ermilindwalekar/f1-dual-controller-stand/analysis/central_seat_15deg_y-20.png

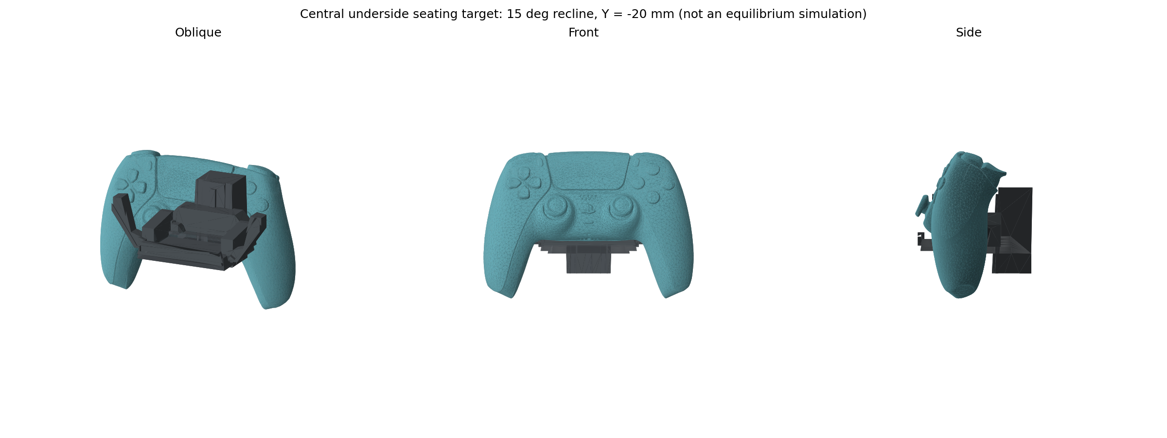
analysis/central_seat_15deg_y-20.png
