ermilindwalekar/f1-dual-controller-stand/analysis/dualsense_scan_views.png

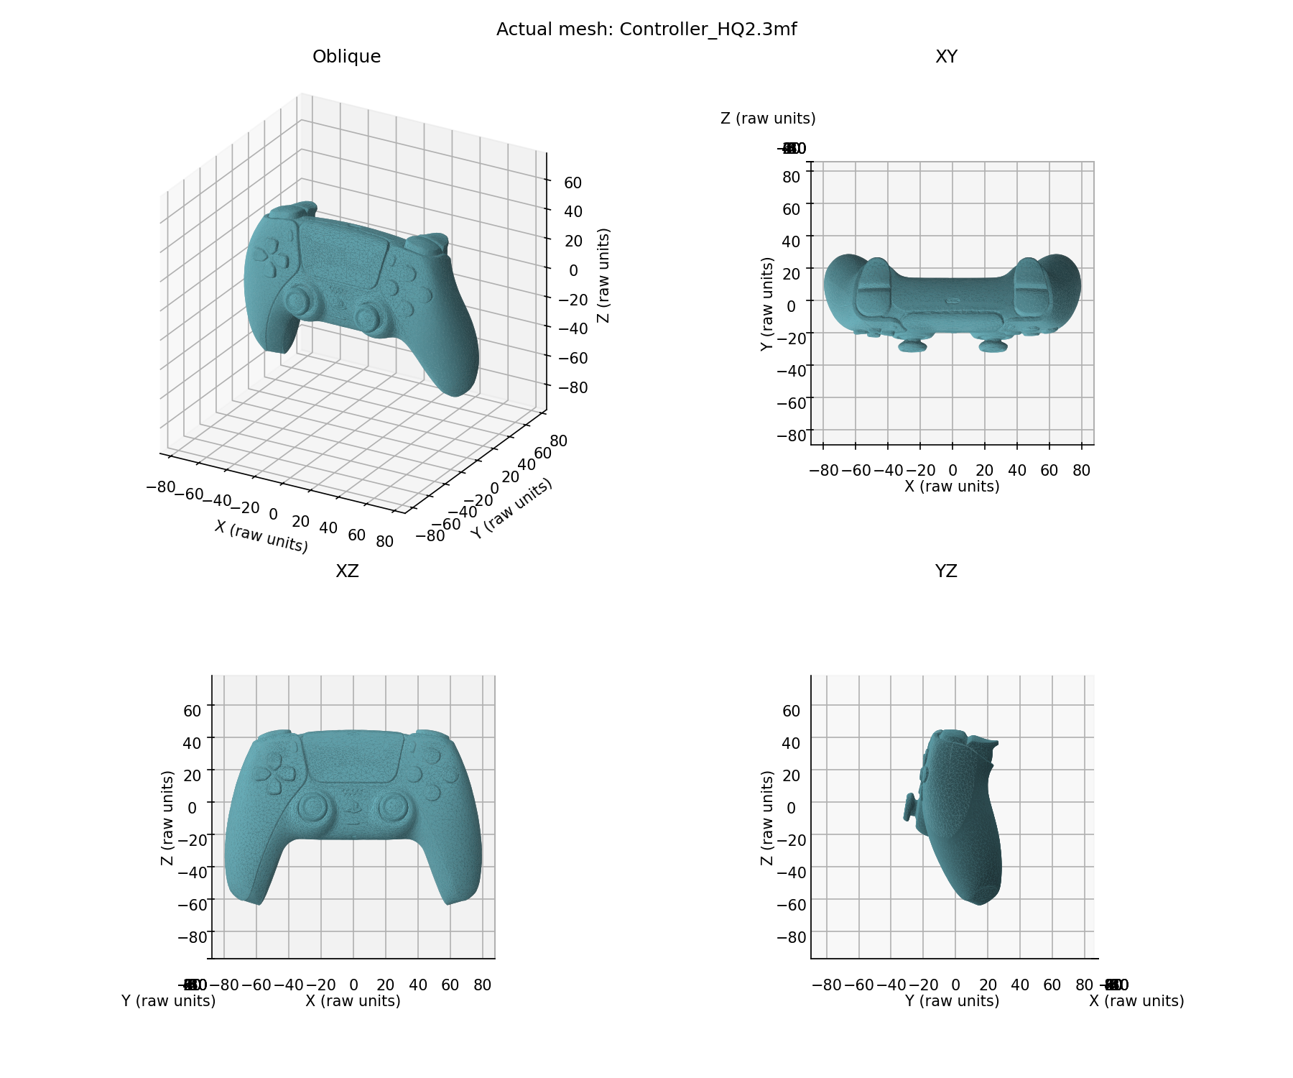
analysis/dualsense_scan_views.png
