ermilindwalekar/f1-dual-controller-stand/analysis/first_reference_mesh.png

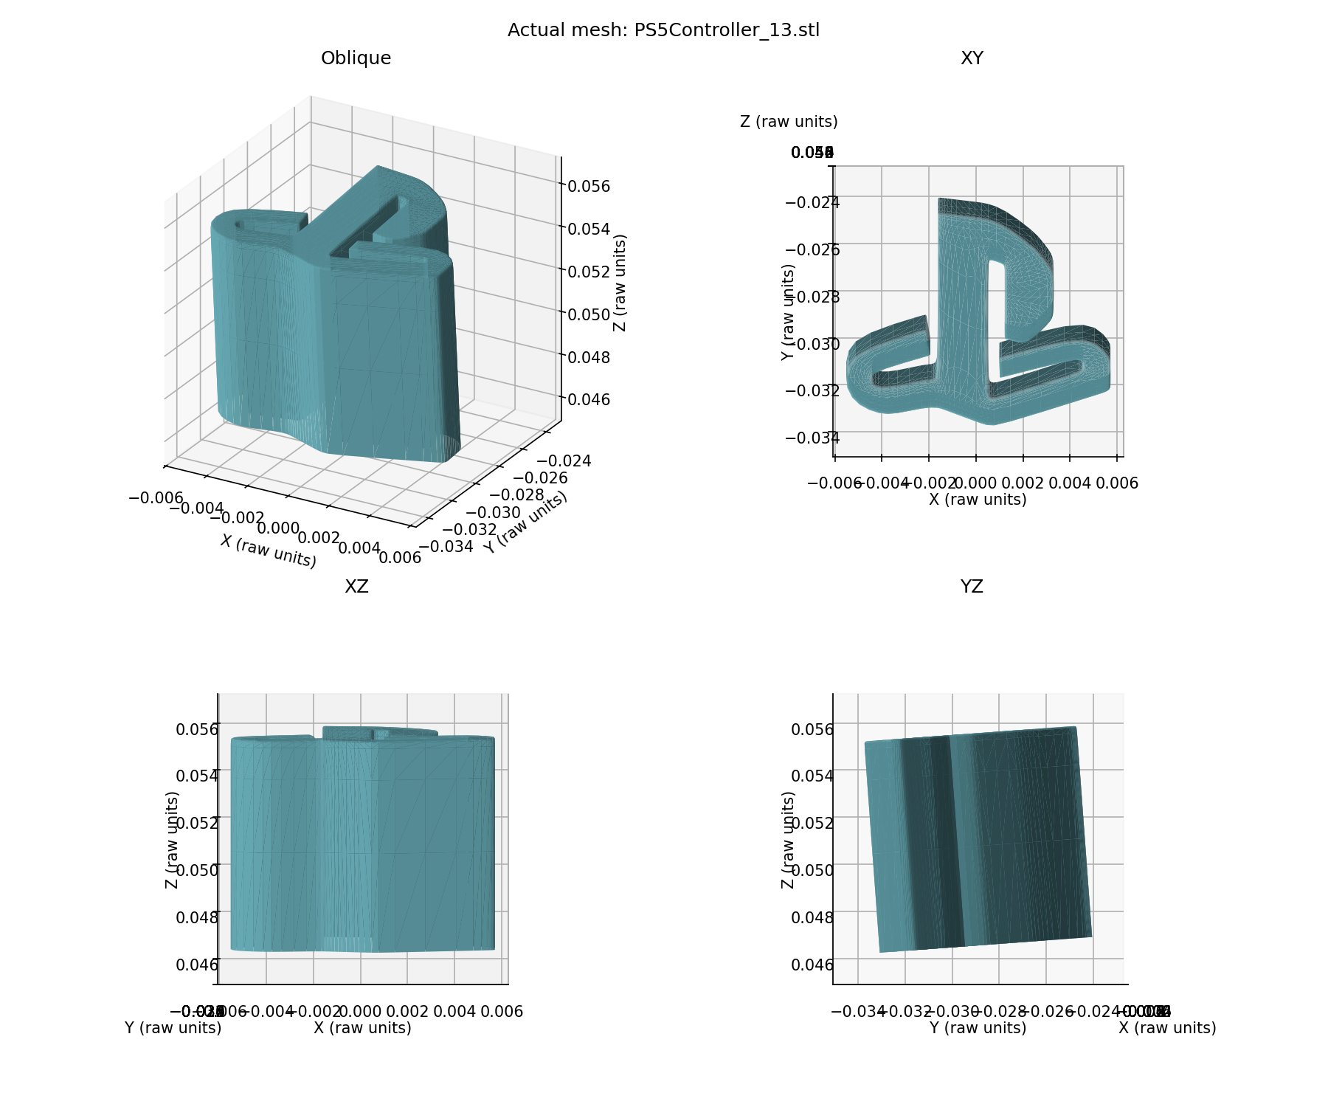
analysis/first_reference_mesh.png
