ermilindwalekar/f1-dual-controller-stand/analysis/fit_pose_0deg.png

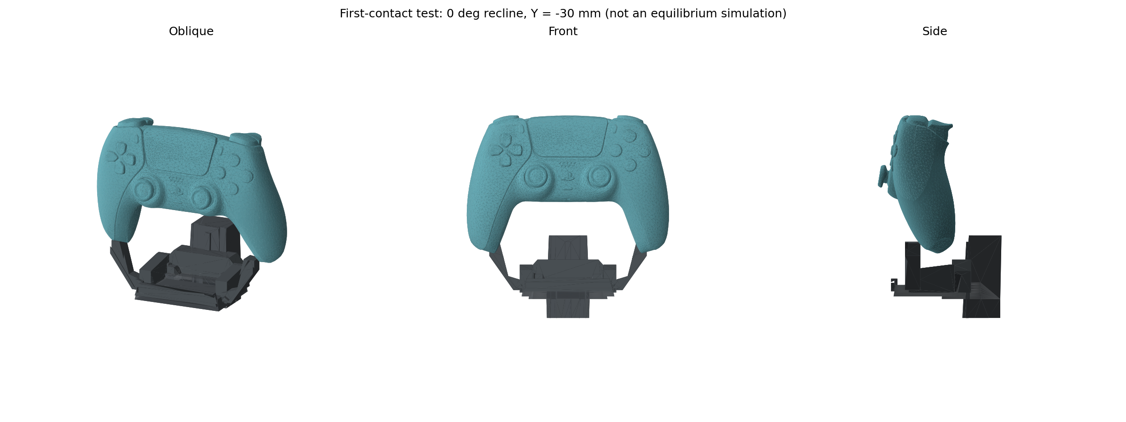
analysis/fit_pose_0deg.png
