ermilindwalekar/f1-dual-controller-stand/analysis/fit_pose_60deg.png

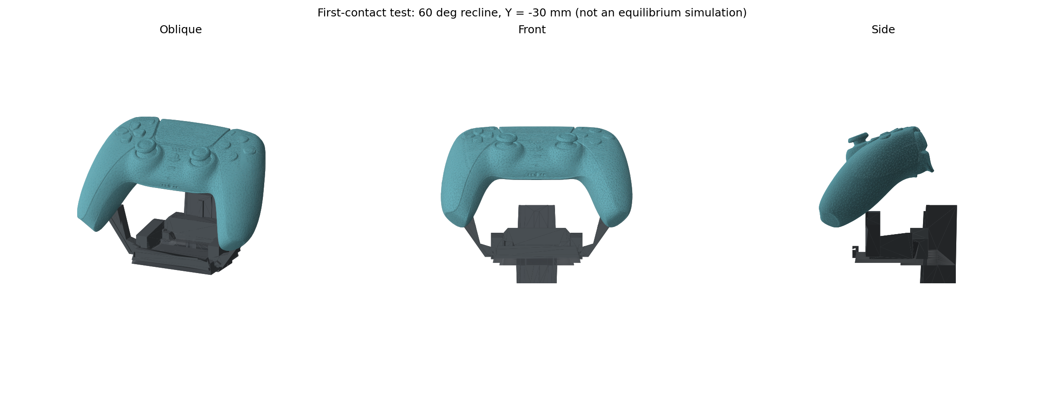
analysis/fit_pose_60deg.png
