ermilindwalekar/f1-dual-controller-stand/f1_dual_controller_stand_cradle_detail.png

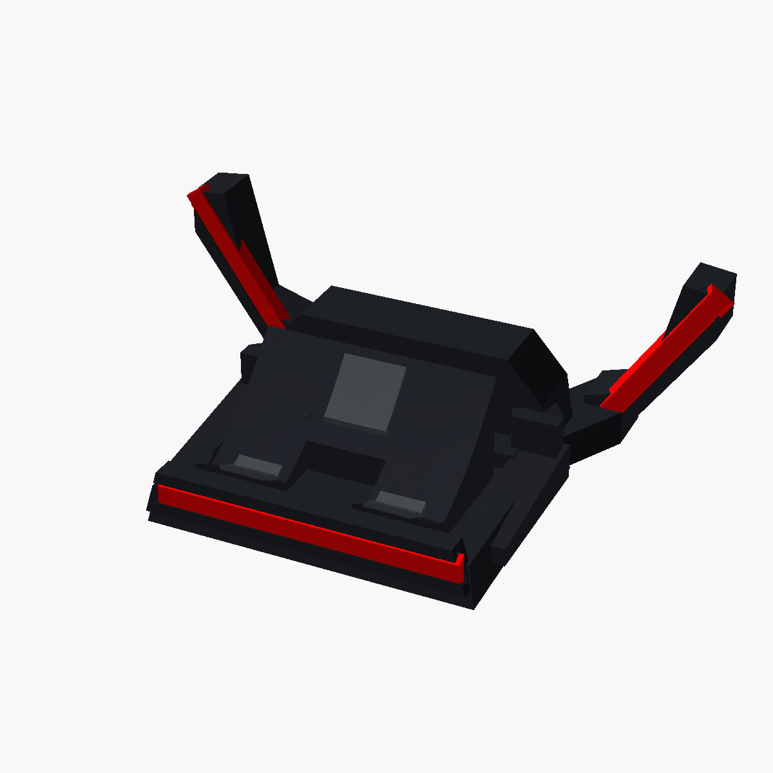
f1_dual_controller_stand_cradle_detail.png
