ermilindwalekar/f1-dual-controller-stand/f1_dual_controller_stand_exploded.png

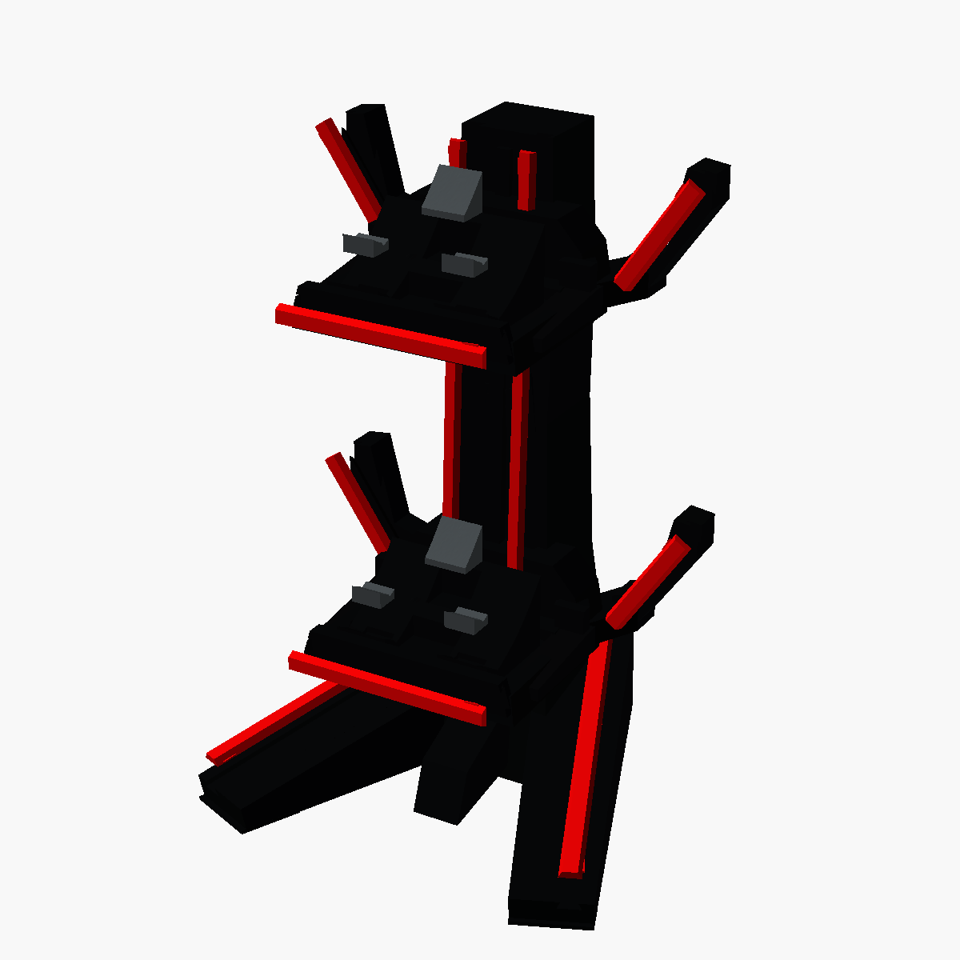
f1_dual_controller_stand_exploded.png
