ermilindwalekar/f1-dual-controller-stand/f1_dual_controller_stand_top.png

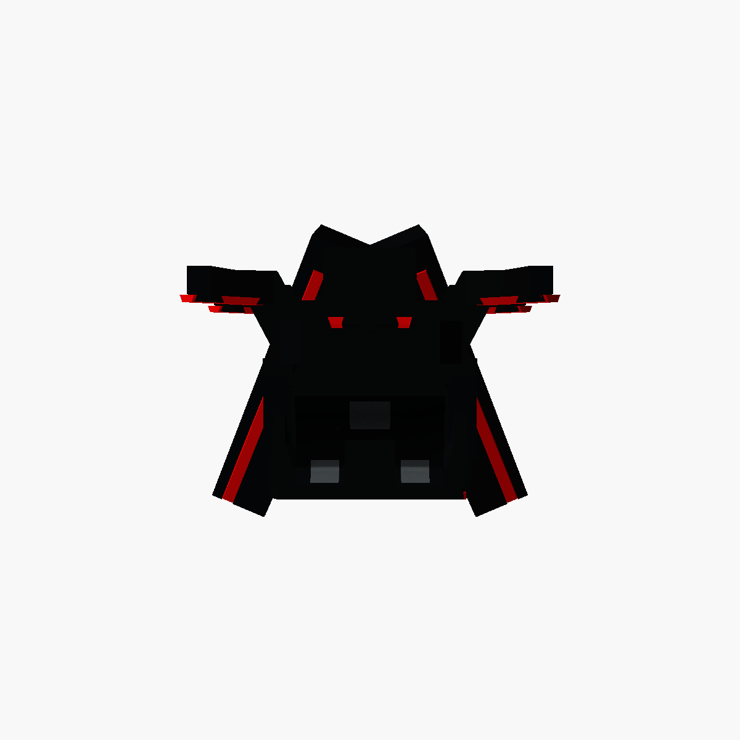
f1_dual_controller_stand_top.png
