ermilindwalekar/f1-dual-controller-stand/references/dualsense-scan/Screenshot_20251229_160554.png

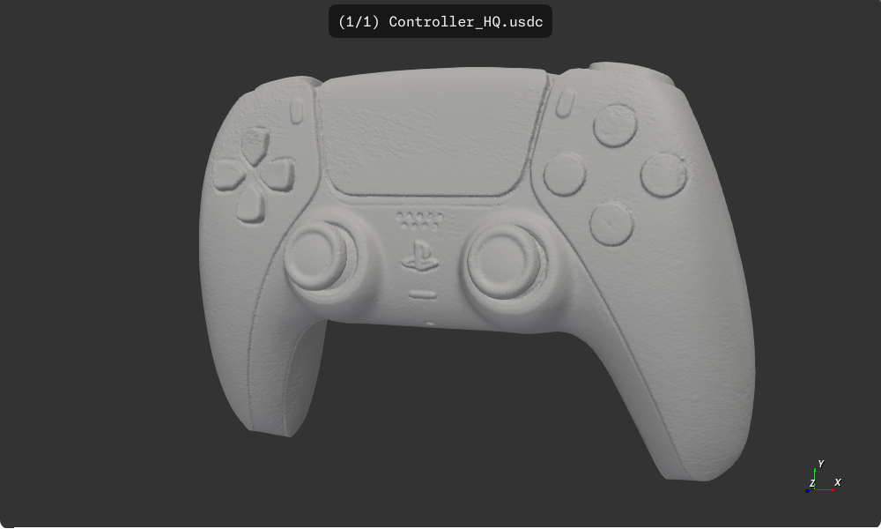
references/dualsense-scan/Screenshot_20251229_160554.png
