ermilindwalekar/f1-dual-controller-stand/references/grabcad-ps5-controller-13/4.png

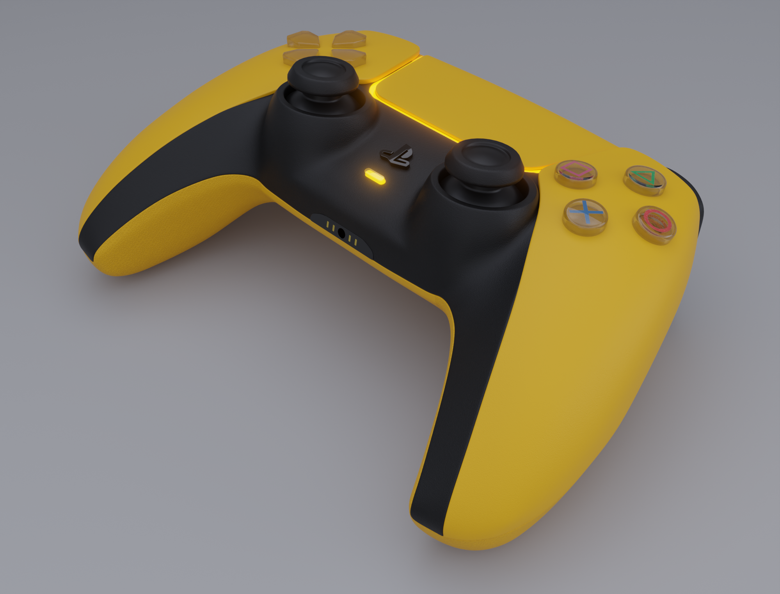
references/grabcad-ps5-controller-13/4.png
