ermilindwalekar/f1-dual-controller-stand/analysis/revised_hard_assembly.stl

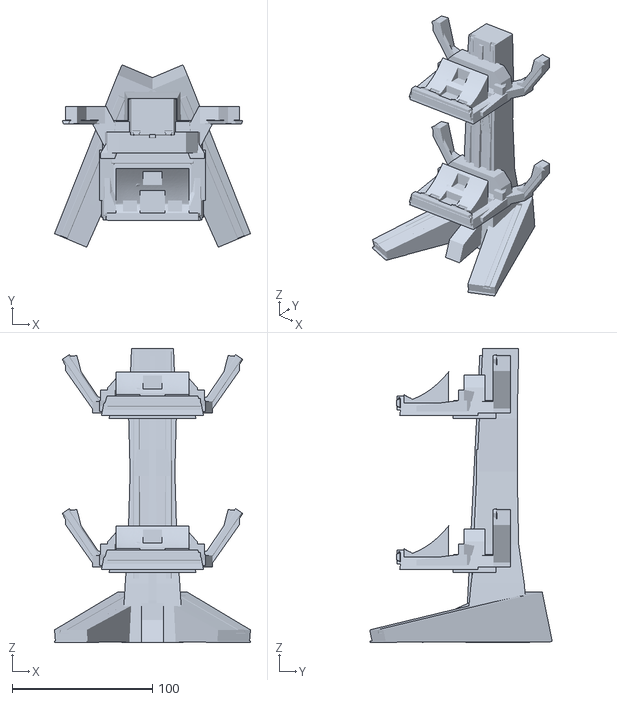
[picture p15: CAD file, 2026-10-31]
analysis/revised_hard_assembly.stl
140.0 x 130.4 x 210.0
