ermilindwalekar/f1-dual-controller-stand/f1_dual_controller_stand_red_spine_inserts.stl

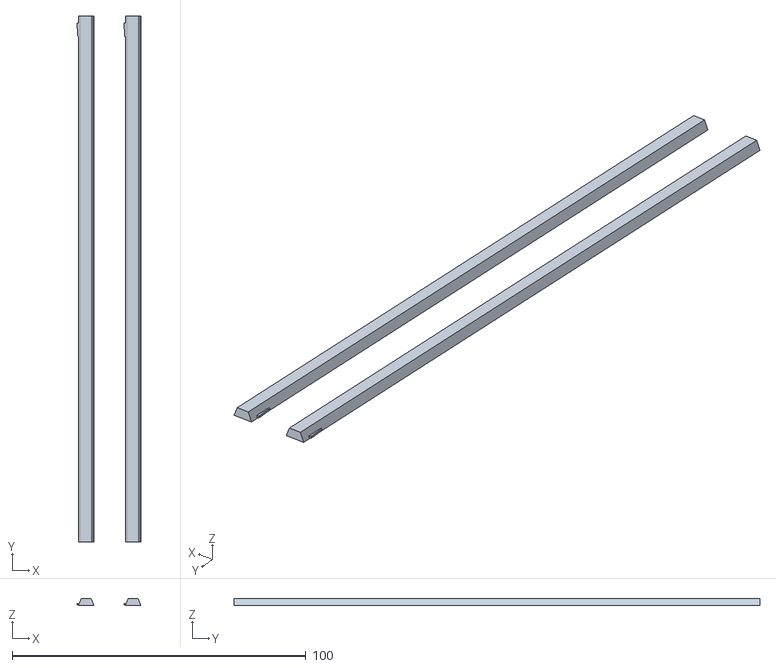
[picture p16: CAD file, 2026-10-31]
f1_dual_controller_stand_red_spine_inserts.stl
21.8 x 179.2 x 2.46
