ermilindwalekar/f1-dual-controller-stand/generated/seat_pad_2.stl

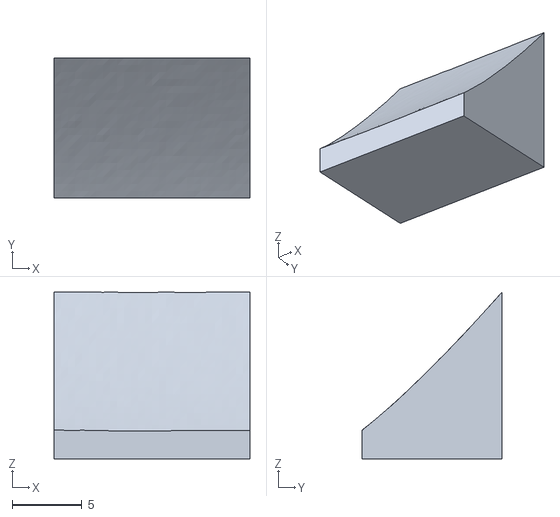
[picture p17: CAD file, 2026-10-31]
generated/seat_pad_2.stl
14.0 x 10.0 x 11.9
