ermilindwalekar/f1-dual-controller-stand/references/dualsense-scan/Controller_HQ2.3mf

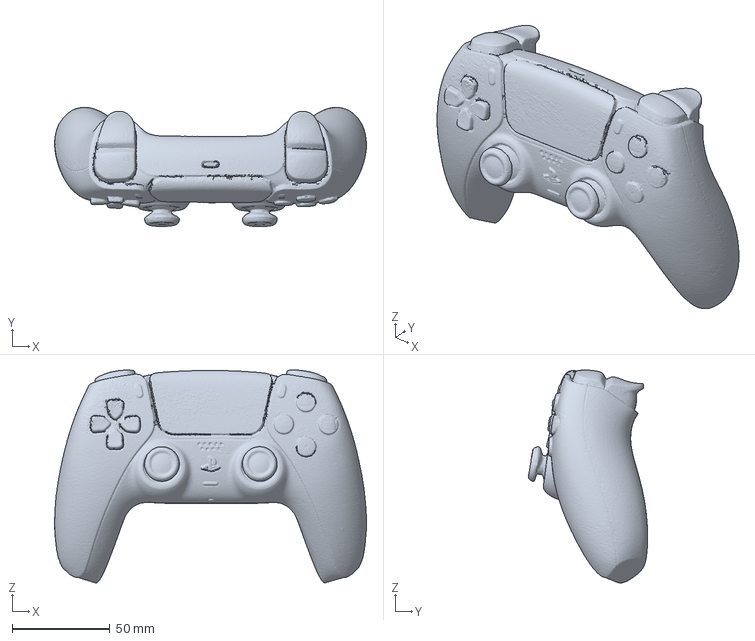
[picture p18: CAD file, 2026-10-31]
references/dualsense-scan/Controller_HQ2.3mf
159.4 x 61.0 x 108.7 mm
