ermilindwalekar/f1-dual-controller-stand/analysis/baseline_body.stl

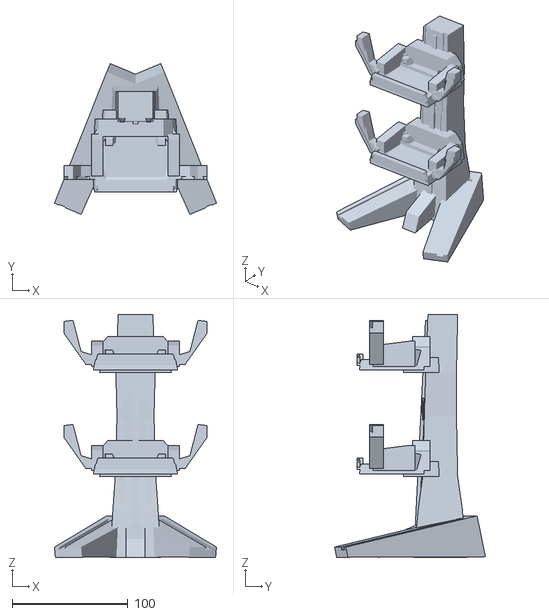
[picture p19: CAD file, 2026-10-31]
analysis/baseline_body.stl
140.0 x 130.4 x 210.0
