ermilindwalekar/f1-dual-controller-stand/generated/seat_pad_1.stl

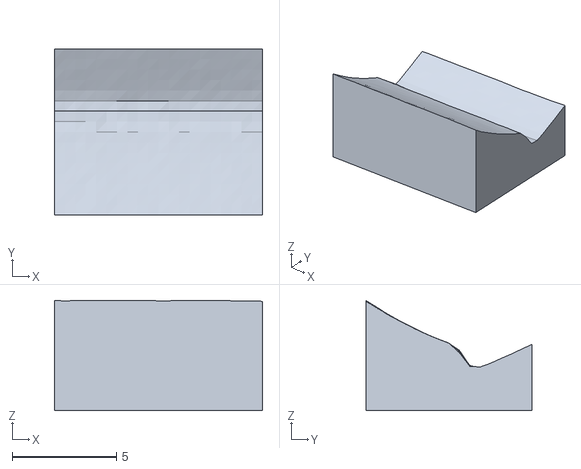
[picture p20: CAD file, 2026-10-31]
generated/seat_pad_1.stl
10.0 x 8.00 x 5.30
