ermilindwalekar/f1-dual-controller-stand/insert_fit_coupon_insert.stl

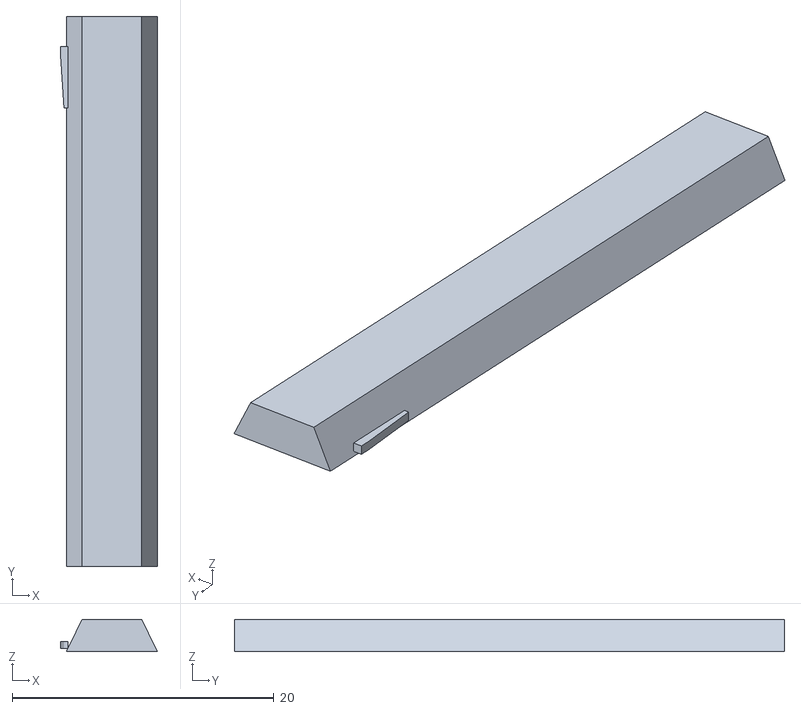
[picture p21: CAD file, 2026-10-31]
insert_fit_coupon_insert.stl
7.40 x 42.0 x 2.46
