ermilindwalekar/f1-dual-controller-stand/f1_dual_controller_stand_tpu_pads.stl

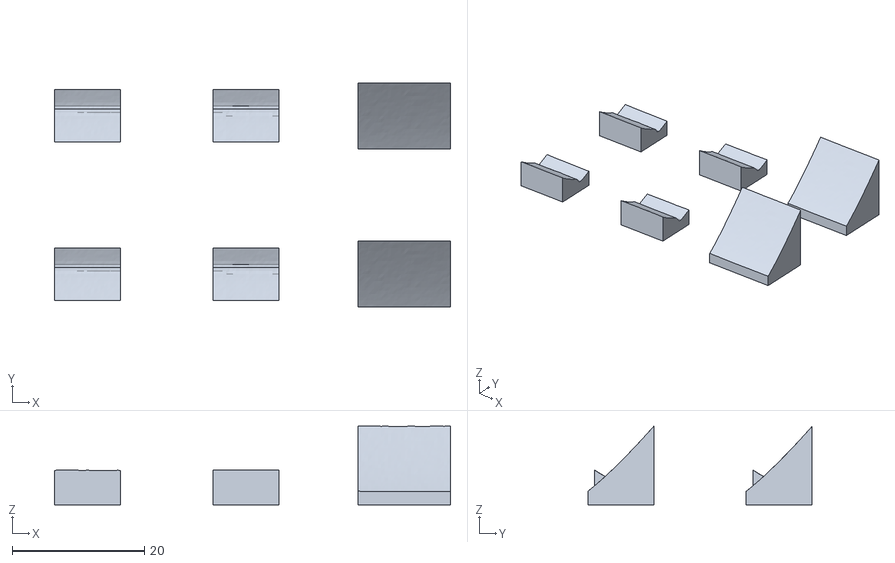
[picture p22: CAD file, 2026-10-31]
f1_dual_controller_stand_tpu_pads.stl
60.0 x 34.0 x 11.9
