ermilindwalekar/f1-dual-controller-stand/analysis/revised_body_test.stl

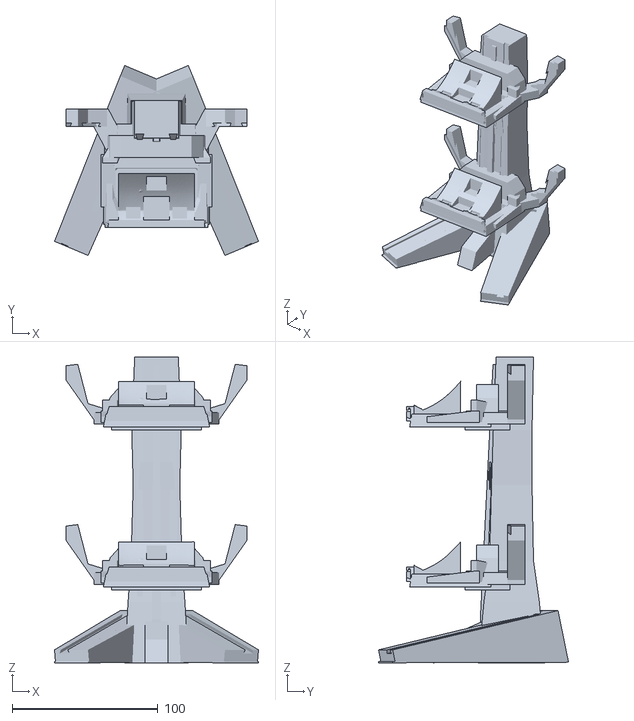
[picture p23: CAD file, 2026-10-31]
analysis/revised_body_test.stl
140.0 x 130.4 x 210.0
