ermilindwalekar/f1-dual-controller-stand/f1_dual_controller_stand_red_base_inserts.stl

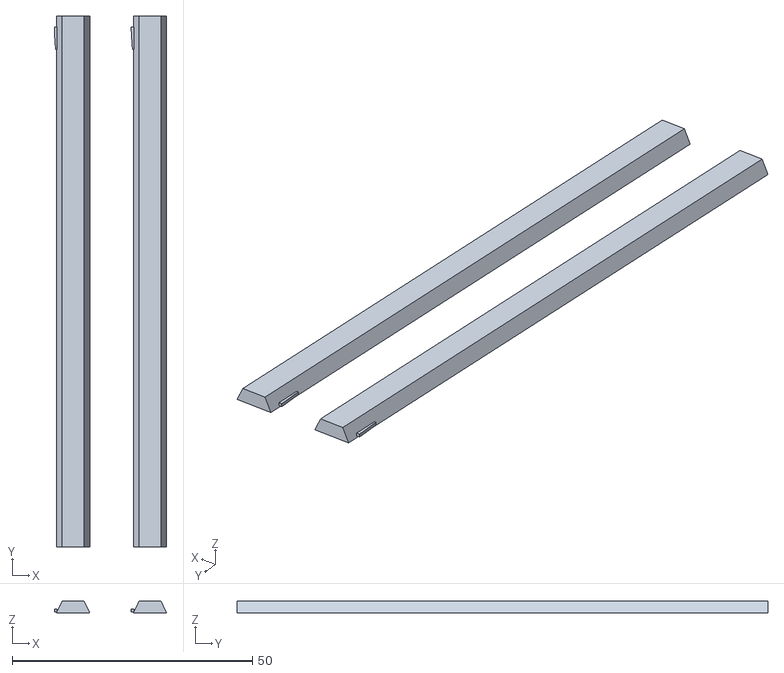
[picture p24: CAD file, 2026-10-31]
f1_dual_controller_stand_red_base_inserts.stl
23.4 x 110.5 x 2.46
