ermilindwalekar/f1-dual-controller-stand/generated/central_seat.stl

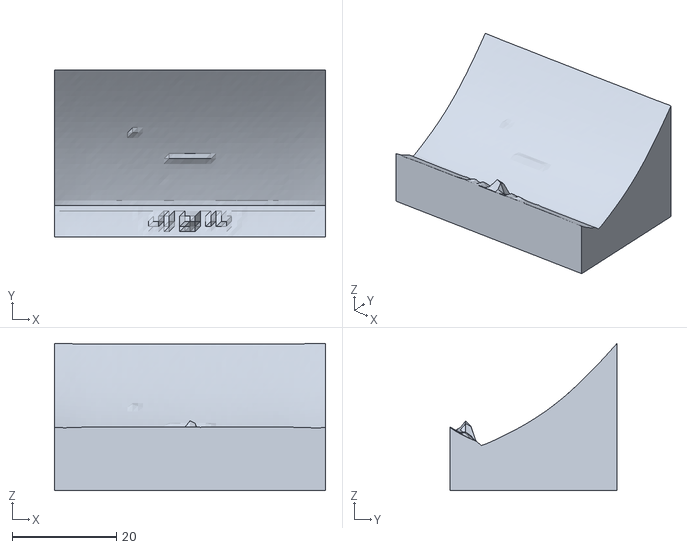
[picture p25: CAD file, 2026-10-31]
generated/central_seat.stl
52.0 x 32.0 x 28.2
