ermilindwalekar/f1-dual-controller-stand/insert_fit_coupon_body.stl

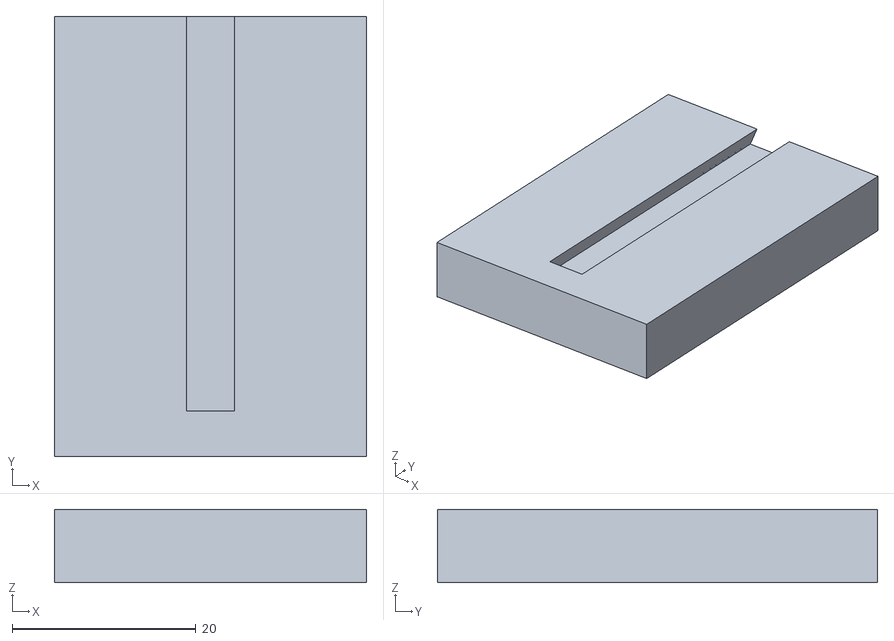
[picture p26: CAD file, 2026-10-31]
insert_fit_coupon_body.stl
34.0 x 48.0 x 8.00
