ermilindwalekar/f1-dual-controller-stand/controller_cradle_fit_test.stl

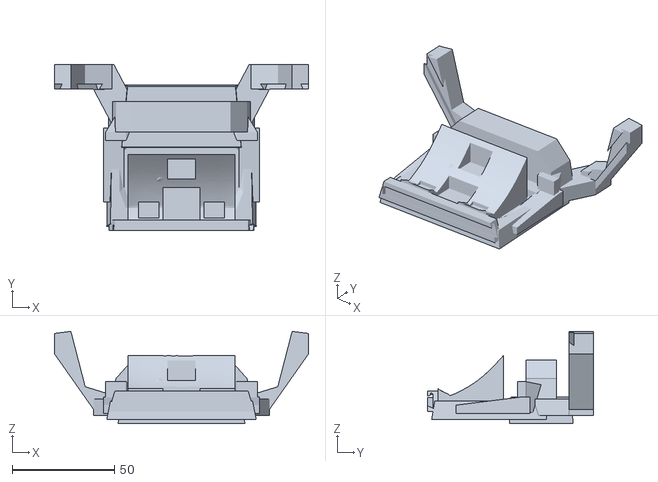
[picture p27: CAD file, 2026-10-31]
controller_cradle_fit_test.stl
124.0 x 81.0 x 45.0
