ermilindwalekar/f1-dual-controller-stand/f1_dual_controller_stand_red_cradle_inserts.stl

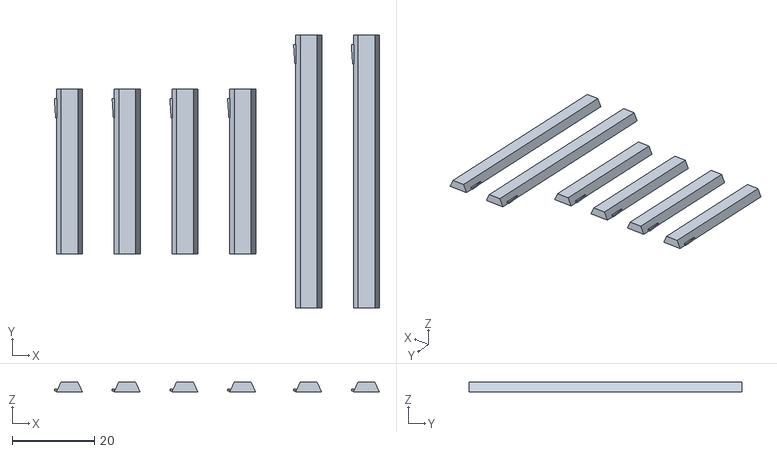
[picture p28: CAD file, 2026-10-31]
f1_dual_controller_stand_red_cradle_inserts.stl
78.8 x 66.2 x 2.46
