ermilindwalekar/f1-dual-controller-stand/f1_dual_controller_stand_red_inserts.stl

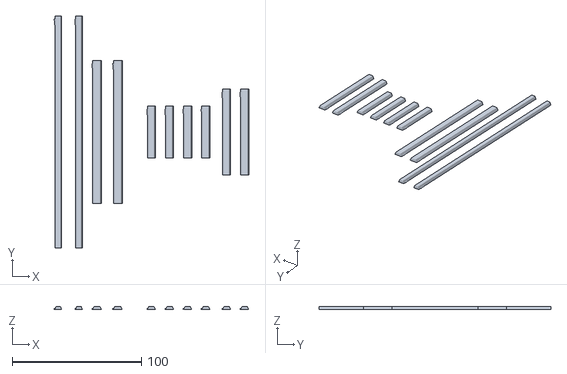
[picture p29: CAD file, 2026-10-31]
f1_dual_controller_stand_red_inserts.stl
150.3 x 179.2 x 2.46
