ermilindwalekar/f1-dual-controller-stand/generated/seat_config.scad

seat_controller_pitch = 30;
seat_controller_y = -28;
seat_controller_height = 31.9;
seat_hard_clearance = 1.25;
seat_pad_centers = [[-16, -42], [16, -42], [0, -22]];
seat_pad_sizes = [[10, 8], [10, 8], [14, 10]];
seat_pad_bottoms = [10.337140571009167, 10.301890882483898, 18.048197913039466];
