ermilindwalekar/f1-dual-controller-stand/(list of files, cad)

Other CAD files:
analysis/base_corrected.stl
generated/seat_pad_0.stl
generated/controller_preview.stl
f1_dual_controller_stand_body.stl
references/grabcad-ps5-controller-13/PS5Controller_13.stl
